rhs-metsanauts/raspi/assets/METSAnauts — HERA Rover & Moonscape Simulation Project.png

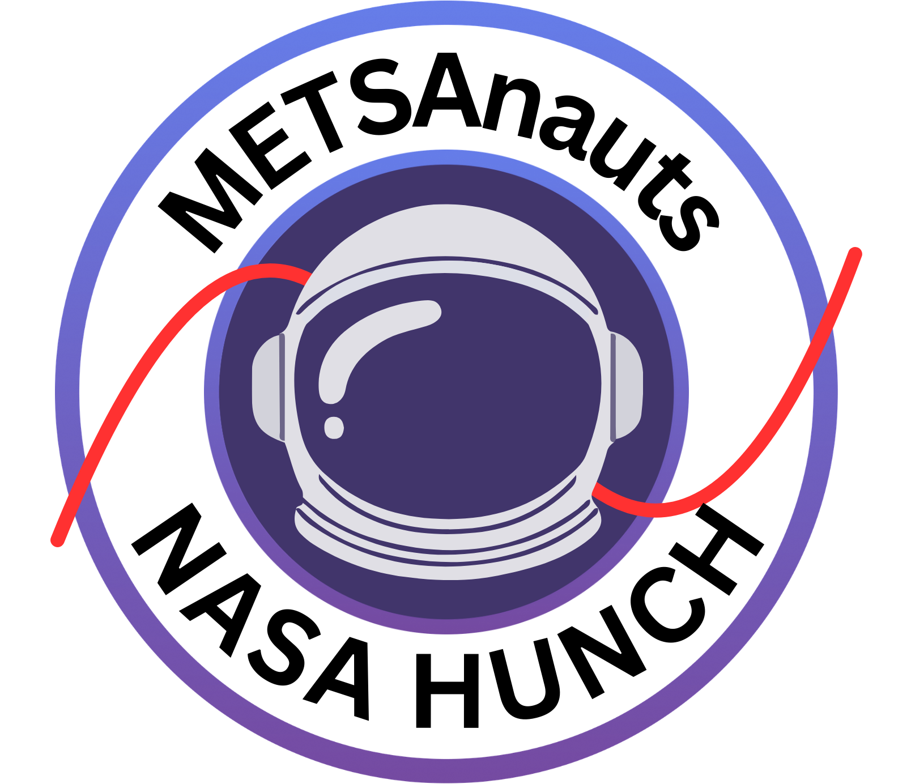
assets/METSAnauts — HERA Rover & Moonscape Simulation Project.png
