rhs-metsanauts/raspi/assets/CAD/BatterHolder.step

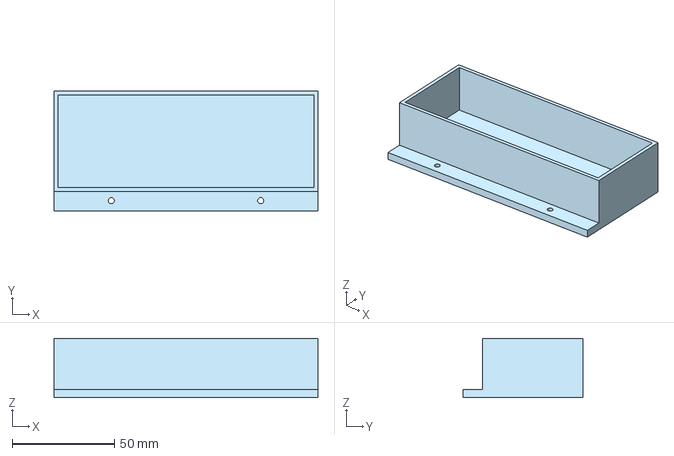
[picture p2: CAD file, 2026-05-21]
assets/CAD/BatterHolder.step
129.0 x 58.5 x 29.0 mm
