rhs-metsanauts/raspi/assets/CAD/Elbow Joint v22.step

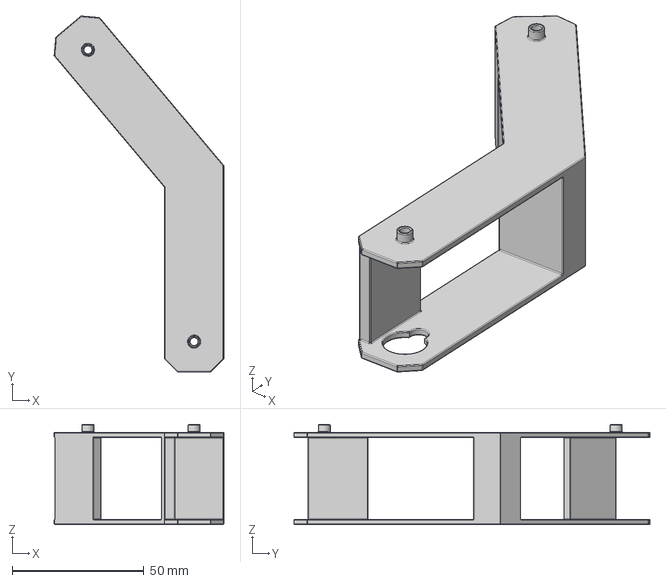
[picture p3: CAD file, 2026-05-21]
assets/CAD/Elbow Joint v22.step
64.3 x 134.9 x 38.0 mm
