rhs-metsanauts/raspi/assets/CAD/Bucket v9.step

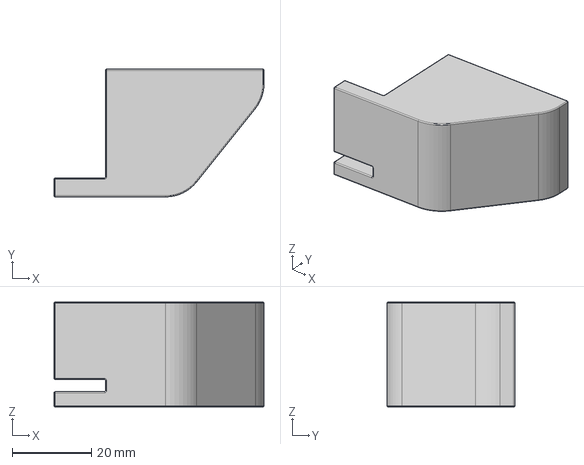
[picture p4: CAD file, 2026-05-21]
assets/CAD/Bucket v9.step
53.0 x 32.3 x 26.5 mm
