rhs-metsanauts/raspi/assets/CAD/Shoulder joint angled v17.step

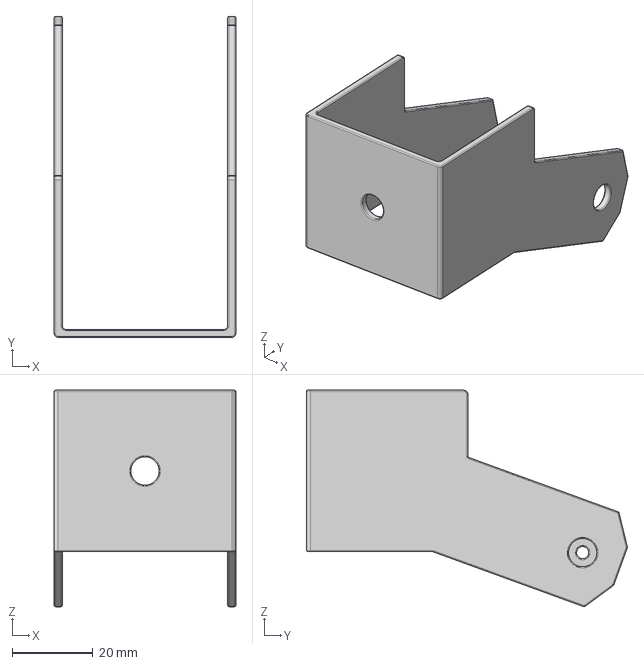
[picture p5: CAD file, 2026-05-21]
assets/CAD/Shoulder joint angled v17.step
45.0 x 79.5 x 53.6 mm
