rhs-metsanauts/raspi/assets/CAD/whelol.step

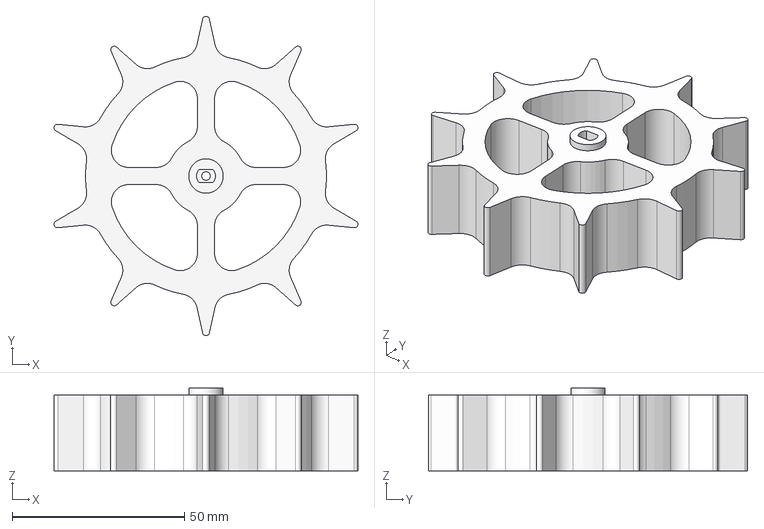
[picture p6: CAD file, 2026-05-21]
assets/CAD/whelol.step
88.3 x 92.8 x 24.0 mm
