rhs-metsanauts/raspi/assets/CAD/Lid v8.step

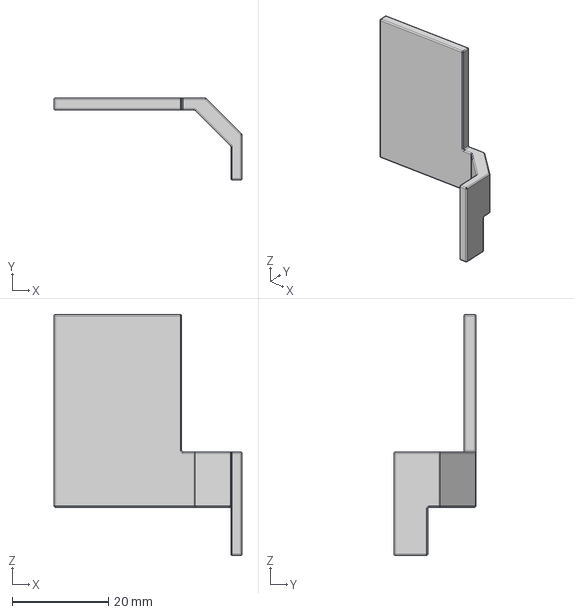
[picture p7: CAD file, 2026-05-21]
assets/CAD/Lid v8.step
39.0 x 17.0 x 50.0 mm
