rhs-metsanauts/raspi/assets/CAD/Wrist Joint v7.step

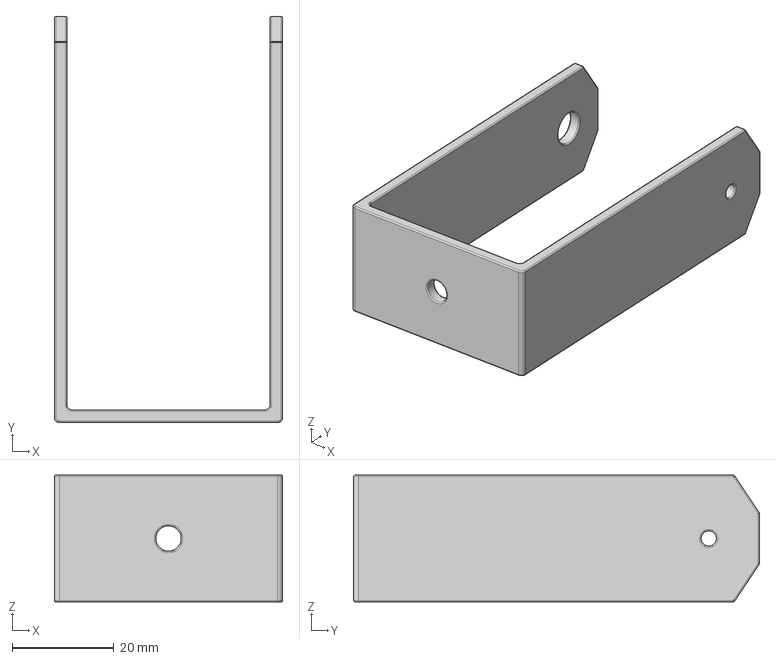
[picture p8: CAD file, 2026-05-21]
assets/CAD/Wrist Joint v7.step
45.0 x 80.0 x 25.0 mm
