rhs-metsanauts/raspi/assets/CAD/base 10cm.step

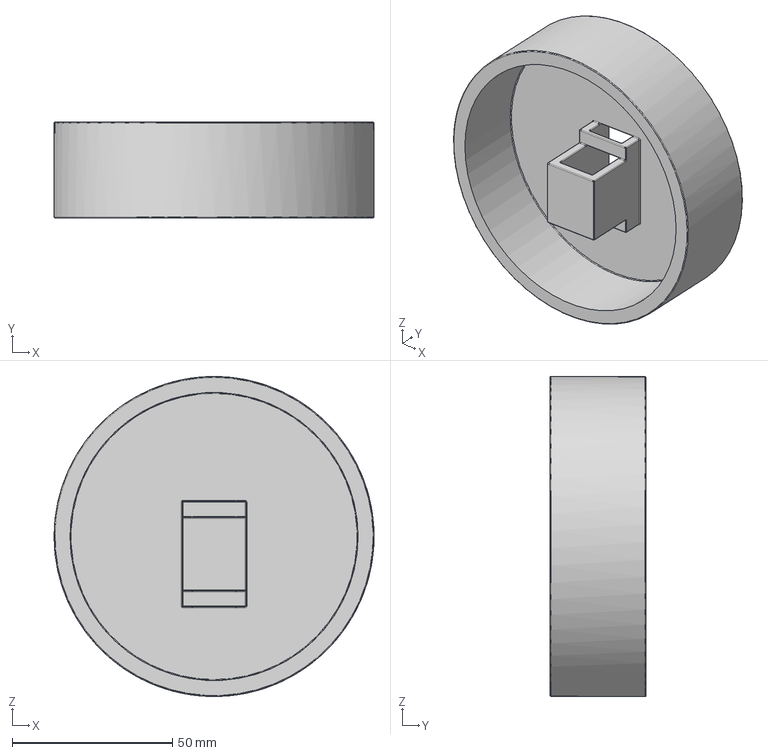
[picture p9: CAD file, 2026-05-21]
assets/CAD/base 10cm.step
100.0 x 30.0 x 100.0 mm
