rhs-metsanauts/raspi/assets/CAD/BUCKET.step

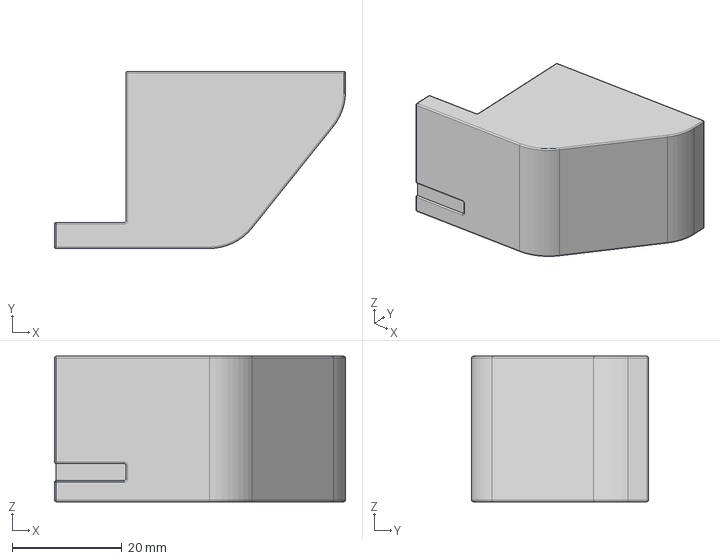
[picture p10: CAD file, 2026-05-21]
assets/CAD/BUCKET.step
53.0 x 32.3 x 26.5 mm
