rhs-metsanauts/raspi/assets/CAD/Bucket v9 (1).step

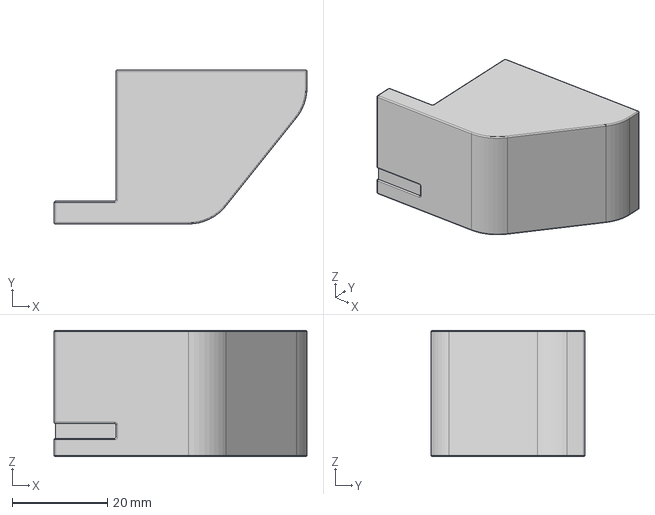
[picture p11: CAD file, 2026-05-21, an earlier design]
assets/CAD/Bucket v9 (1).step
53.0 x 32.3 x 26.5 mm
