rhs-metsanauts/raspi/(list of files, cad)

Other CAD files:
assets/CAD/Base_Mount_Claw.step
