rhs-metsanauts/raspi/communications/lora/transmitter_lora.py

# save as code.py on the Lora module


import board
import digitalio
import keypad
import adafruit_rfm9x
import time
import json
import random

endian = 'little'

# Define radio frequency in MHz. Must match your
# module. Can be a value like 915.0, 433.0, etc.
RADIO_FREQ_MHZ = 915.0

# Define Chip Select and Reset pins for the radio module.
CS = digitalio.DigitalInOut(board.RFM_CS)
RESET = digitalio.DigitalInOut(board.RFM_RST)

# Initialise RFM95 radio
rfm95 = adafruit_rfm9x.RFM9x(board.SPI(), CS, RESET, RADIO_FREQ_MHZ)
rfm95.tx_power = 23  # Max transmission power (5-23 dBm)

def create_packets(json_data, recipient_id, packet_content_id):
    """
    Create packets from JSON data with the specified structure.
    
    The adafruit_rfm9x library adds a 4-byte header to every packet.
    The RFM95 FIFO max is 252 bytes, so our payload max is 248 bytes.
    
    Packet structure (248 bytes payload):
    - Byte 0: Recipient ID (1 byte)
    - Bytes 1-4: Unique Packet Content ID (4 bytes)
    - Bytes 5-6: Index (2 bytes, 0-65535)
    - Bytes 7-8: Total number of indexes (2 bytes)
    - Bytes 9-247: Message content (239 bytes per chunk)
    """
    # Convert JSON to bytes
    json_bytes = json.dumps(json_data).encode('utf-8')
    
    # Max payload = 252 (FIFO) - 4 (library header) = 248
    # Our header = 9 bytes, so chunk = 248 - 9 = 239
    chunk_size = 239
    total_chunks = (len(json_bytes) + chunk_size - 1) // chunk_size
    
    if total_chunks > 65535:
        raise ValueError(f"Data too large: {total_chunks} chunks needed, max is 65535")
    
    packets = []
    for index in range(total_chunks):
        # Extract chunk of data
        start = index * chunk_size
        end = min(start + chunk_size, len(json_bytes))
        chunk = json_bytes[start:end]
        
        # Pad chunk to 243 bytes if it's the last one and shorter
        chunk = chunk + b'\x00' * (chunk_size - len(chunk))
        
        # Build packet
        packet = bytearray()
        packet.append(recipient_id & 0xFF)  # Byte 0: Recipient ID (1 byte)
        packet.extend(packet_content_id.to_bytes(4, endian))  # Bytes 1-4: Packet Content ID
        packet.extend(index.to_bytes(2, endian))  # Bytes 5-6: Index
        packet.extend(total_chunks.to_bytes(2, endian))  # Bytes 7-8: Total chunks
        packet.extend(chunk)  # Bytes 9-251: Content (243 bytes)
        
        packets.append(bytes(packet))
    
    return packets

# Read JSON from file
with open('message.json', 'r') as f:
    # Read as text and strip any BOM or whitespace
    content = f.read().strip()
    # Remove BOM if present
    if content.startswith('\ufeff'):
        content = content[1:]
    json_data = json.loads(content)

# Extract recipient ID from JSON
recipient_id = json_data.get('Recipient', 0)

# Packet content ID starts at 0 and increments for each transmission
packet_content_id = 0

# Create packets
packets = create_packets(json_data, recipient_id, packet_content_id)

# Send packets
print(f'Sending {len(packets)} packet(s) to recipient {recipient_id}')
print(f'Packet Content ID: {packet_content_id}')
print(f'Total data size: {len(json.dumps(json_data))} bytes')
print('-' * 50)

for i, packet in enumerate(packets):
    rfm95.send(packet)
    print(f'✓ Sent packet {i+1}/{len(packets)} (Index: {i})')
    time.sleep(0.1)

print('-' * 50)
print(f'Successfully sent all packets to recipient {recipient_id}')
