rhs-metsanauts/raspi/testing_files/RockerBogieSubsystemTest.py

import pi_servo_hat
import time

test = pi_servo_hat.PiServoHat()

test.restart()

# Moves servo position to 0 degrees (1ms), Channel 0


#right main, left main, right back, left back
servo_positions = [150, 35, 90, 90]
for index, pos in enumerate(servo_positions):
    test.move_servo_position(index, pos)

print('moved')

time.sleep(10)

#Input 1 = GPIO 17
#Input 2= GPIO 27
#Input 3 = GPIO 22
#Input 4 = GPIO 24
