rhs-metsanauts/raspi/(commit log)

2026-02-11 basic wifi communication functionality
    flask server runs on laptop, main.py runs on raspberry pi
2026-02-13 Implement Camera class and integrate with Rover
    Added Camera class for capturing images using OpenCV. Integrated camera functionality into the Rover class for taking pictures and saving them in PNG and base64 formats.
2026-02-14 Add image read/display & revamp web UI
    Add read_image support and inline image display while overhauling the web UI. main.py: import base64 and implement a read_image payload handler that returns base64-encoded image data, mime_type and size; update supported types. templates/index.html: major visual redesign (NASA/Rover themed), add read_image form fields, improved styling and JS displayResponse logic to render image_data as data URIs and present responses in collapsible, labeled fields. Robot.py: remove saving images as base64 text files (save PNG only), update docstrings and example paths. Cleanup: delete several unused hardware/plotting/server scripts (L298N.py, PlotIntensity.py, PolarPl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
    [LDR.py, MPU-Interpreter.py, MPU6050.py, PlotLDR.py, Robot.py, RockerBogieSubsystemTest.py, ServoTest.py, main.py]
2026-02-14 Fixed image capture filepath and added directory creation
    [Robot.py]
2026-02-16 Update LoRA path, error handling, and UI hint
    Point LORA_MESSAGE_PATH to the specific drive (D:\\message.json) so the Windows-mounted LoRA transmitter can read/write messages. Add FileNotFoundError/OSError handling in the LoRA send routine to return a 503 and a clear error when the drive/module is not accessible. Update the LoRA destination label in the UI to note that ID 255 broadcasts to all nodes. These changes improve reliability and clarify behavior for users.
    [FlaskServer.py]
2026-02-19 Add LDR sensor support and face_sun demo
    Introduce an LDR class to read light levels via GPIO (RC timing method). Integrate the LDR into Rover (initialized as self.ldr) and add convenience methods Rover.read_light_level() and Rover.is_light_covered(). Default LDR config: resistor_pin=16, covered_threshold=8; read_light_level returns milliseconds. Add face_sun.py demo script that rotates the rover while printing light readings to help aim the rover toward brighter areas.
2026-02-19 Revert "Merge branch 'main' of https://github.com/rhs-metsanauts/raspi"
    This reverts commit f9dd183bcecbc932762867bb067c97f3ccd91b41, reversing
    changes made to 3caa28f94bba375f2725a109598333e7e88b485e.
    [LDR.py]
2026-02-19 Revert "Add LDR sensor support and face_sun demo"
    This reverts commit 3caa28f94bba375f2725a109598333e7e88b485e.
    [Robot.py]
2026-05-21 Reorganize codebase into server/, hardware/, rover_pi/, communications/, assets/
    Move Python files into responsibility-based subfolders. Update imports in rover_receiver.py (sys.path) and FlaskServer.py (Robot.py path lookup). Add CODEBASE.md project structure. Gitignore large media, separate website repo, and Claude tooling.
    [BUCKET.step, Base_Mount_Claw.step, BatterHolder.step, Bucket v9 (1).step, Bucket v9.step, Elbow Joint v22 (1).step, Elbow Joint v22.step, Lid v8.step]
